neurobiofisica/IntelSBESC2014/README.md

# IntelSBESC2014

Hardware and Software presented at Intel Embedded Systems Competition at SBESC2014

## How to cite

DOI: [10.13140/RG.2.1.4077.7769](http://dx.doi.org/10.13140/RG.2.1.4077.7769) / [arXiv:1504.00932](http://arxiv.org/abs/1504.00932) \[q-bio.QM\]

> LOB de Almeida, P Matias & RT Guariento - An embedded system for real-time feedback neuroscience experiments,
> In: IV Brazilian Symposium on Computing Systems Engineering - SBESC 2014, Intel Embedded Systems Competition
