neurobiofisica/IntelSBESC2014/doc/slides.pdf

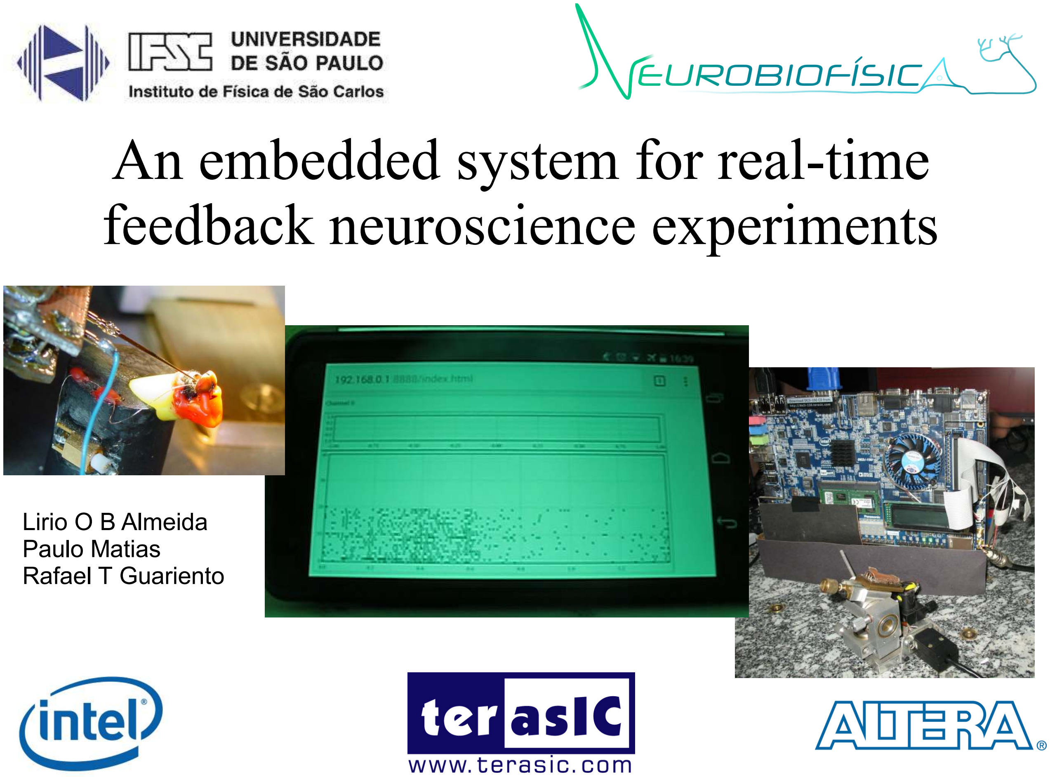
[picture p16: page 1]

An embedded system for real-time feedback neuroscience experiments

Lirio O B Almeida
Paulo Matias
Rafael T Guariento

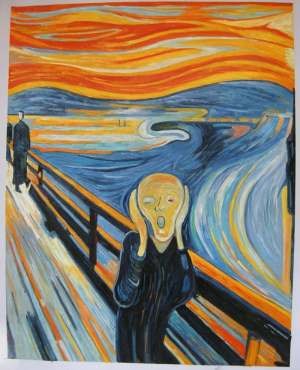
[picture p17: figure]

Why study neuroscience?

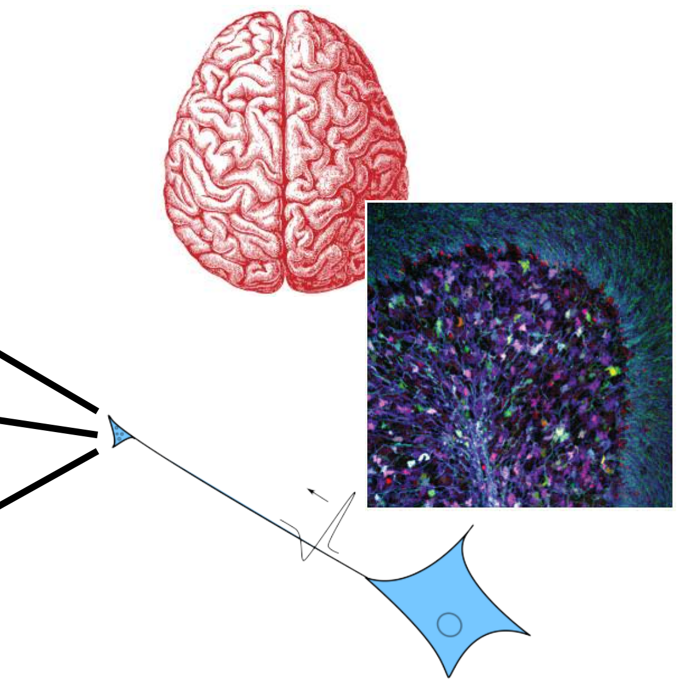
[picture p18: figure]
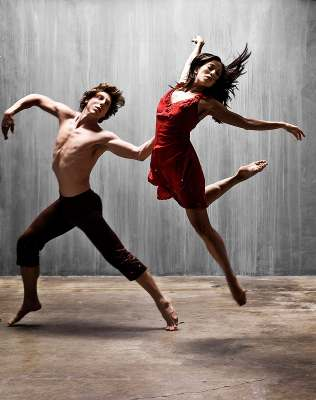
[picture p19: figure]
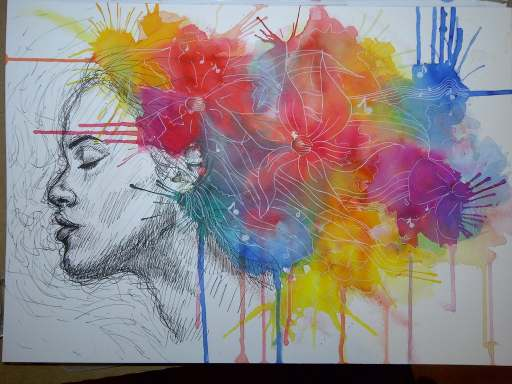
[picture p20: figure]

Neural Code

V

Neural Code

V

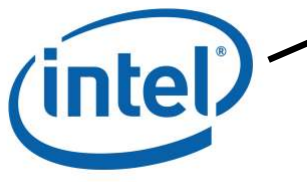
[picture p21: figure]

Encode

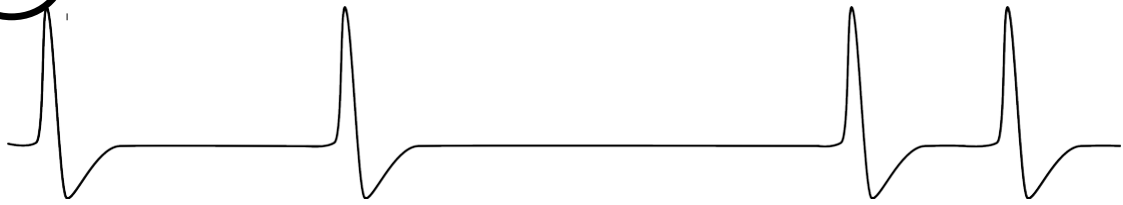
[picture p22: figure]

1 | 0 | 1 | 0 | 0 | 0 | 1 | 1

Neural Code

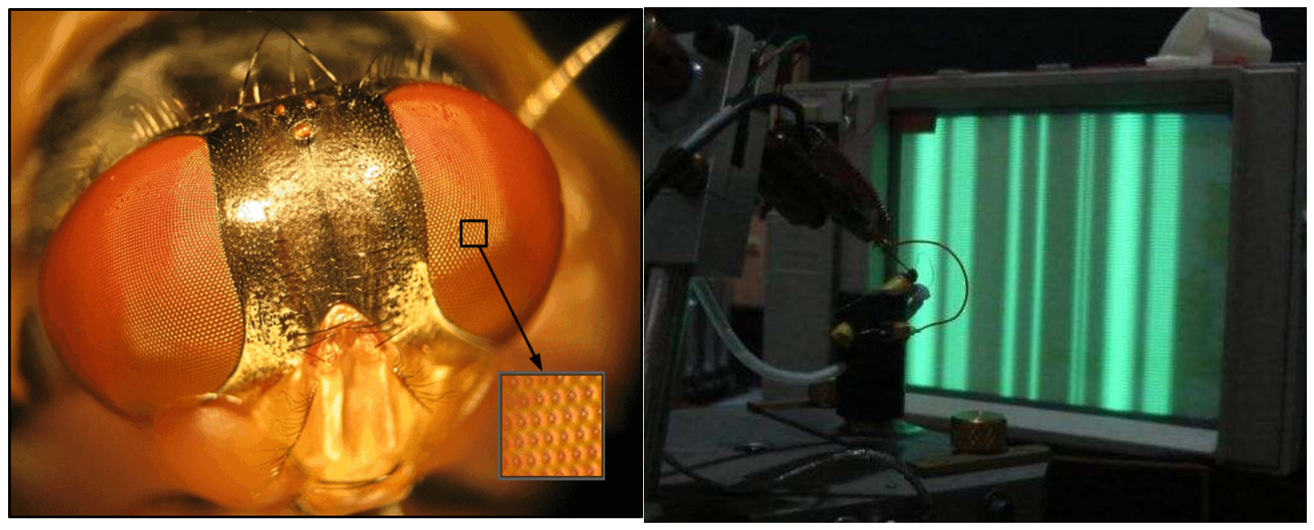
[picture p23: figure]

V

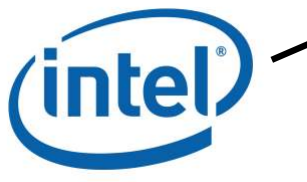
[picture p24: figure]

Encode

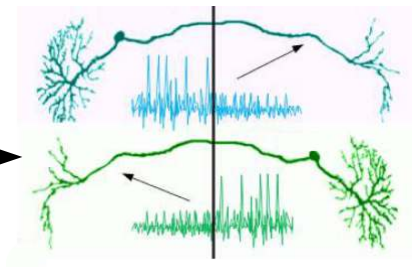
[picture p25: figure]

1 | 0 | 1 | 0 | 0 | 0 | 1 | 1

Neural Code

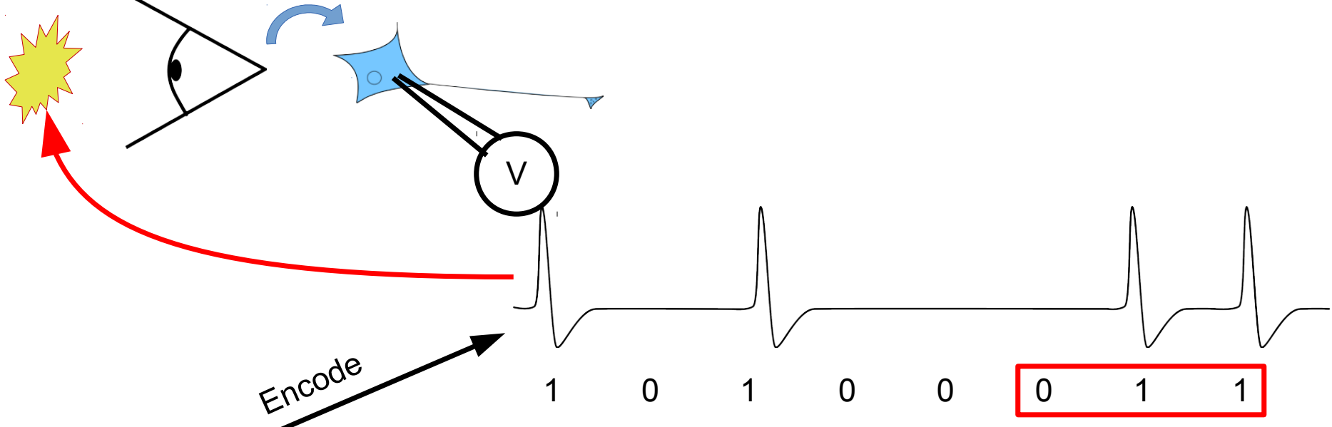
[picture p26: figure]
Encode
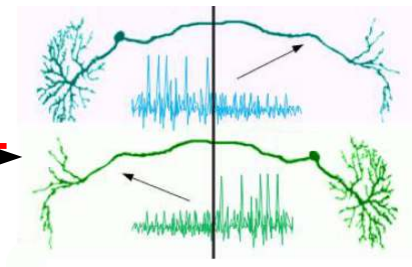
[picture p27: figure]
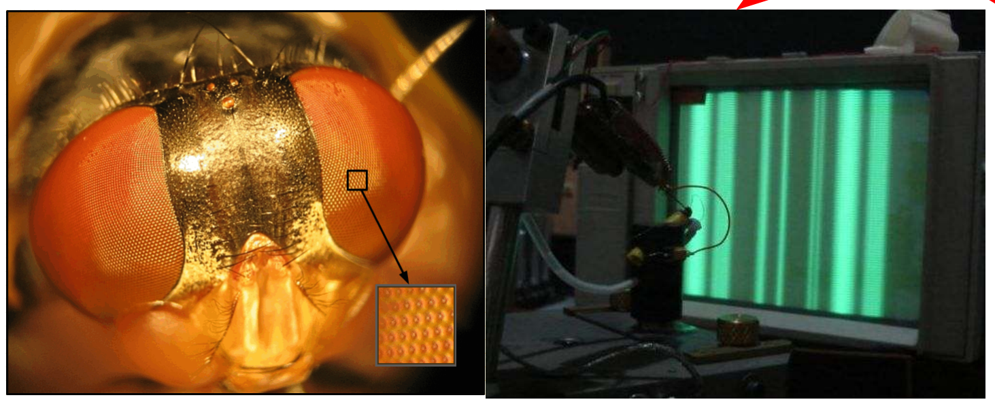
[picture p28: figure]
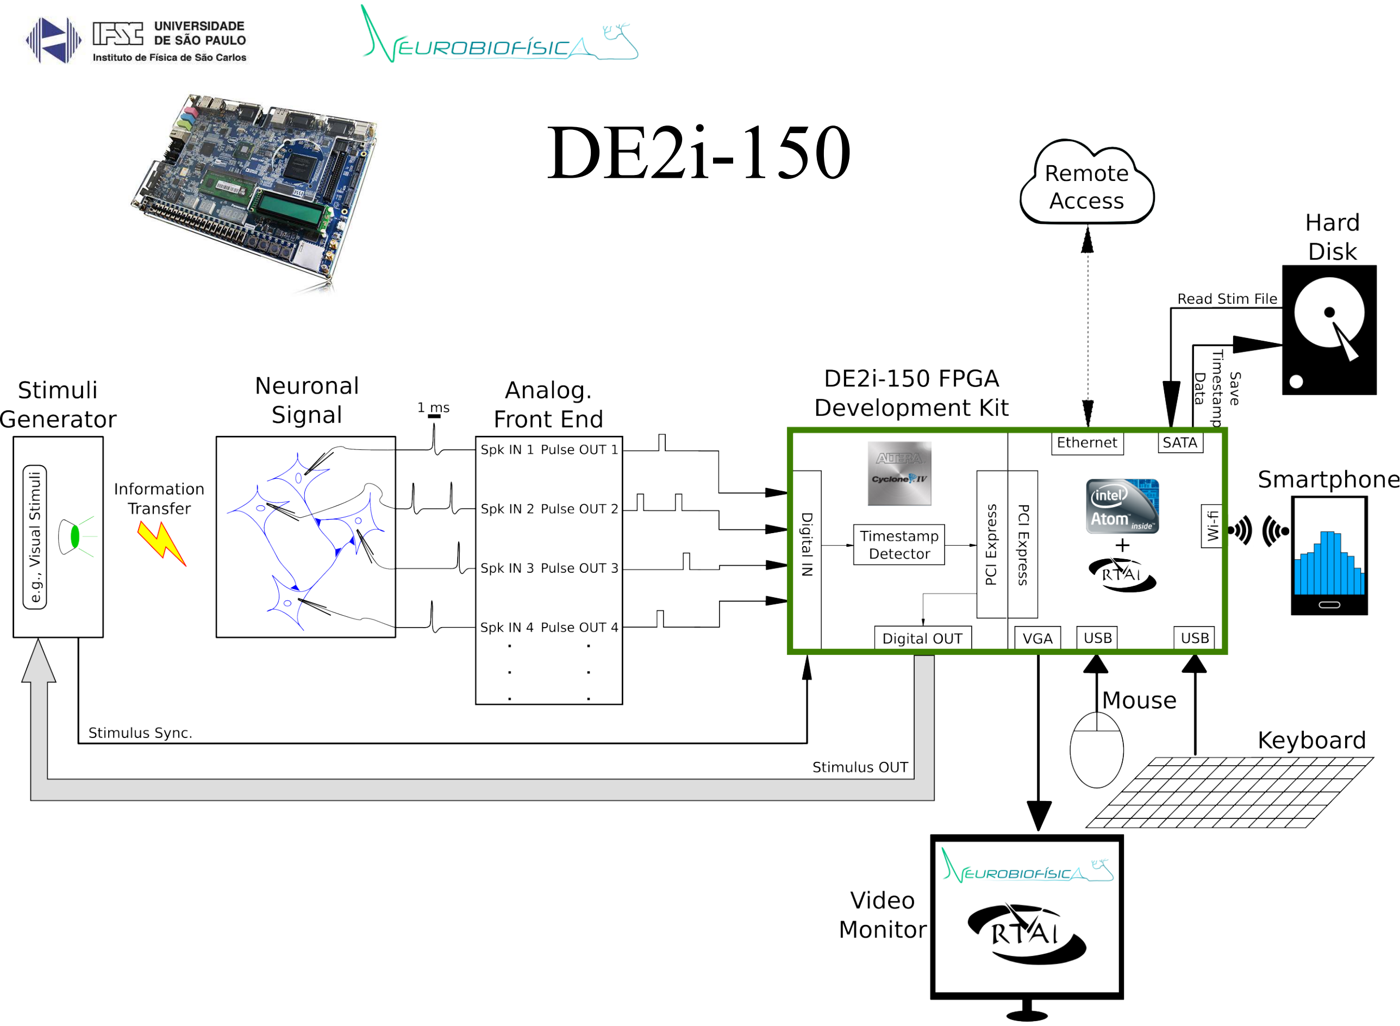
[picture p29: page 7]

DE2i-150

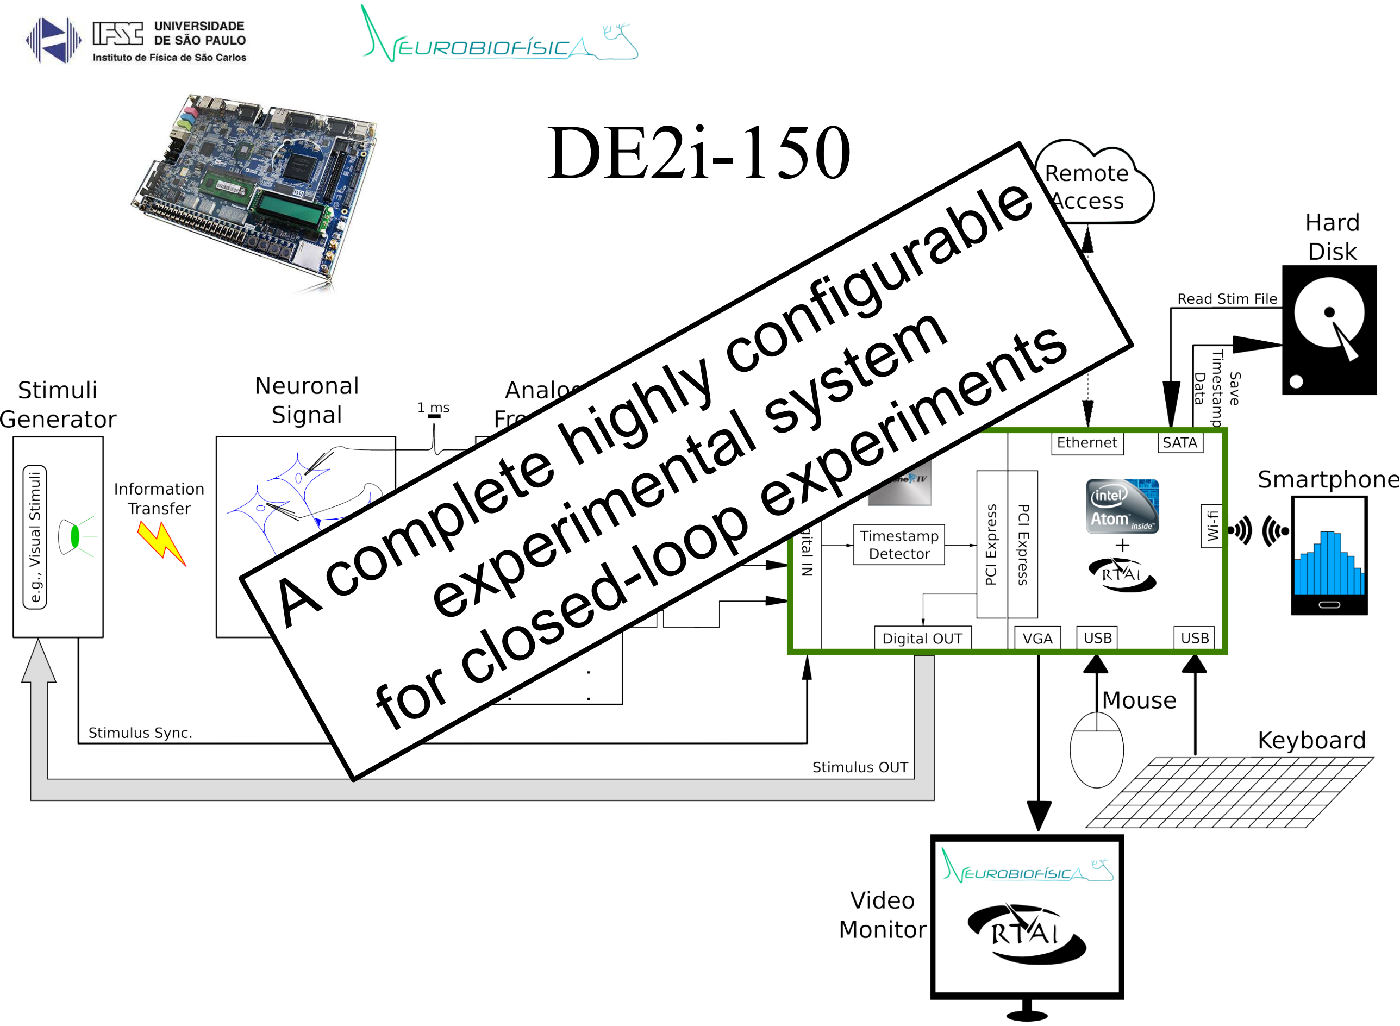
[picture p30: page 8]

DE2i-150
A complete highly configurable

experimental system
for closed-loop experiments

FPGA Altera Cyclone IV

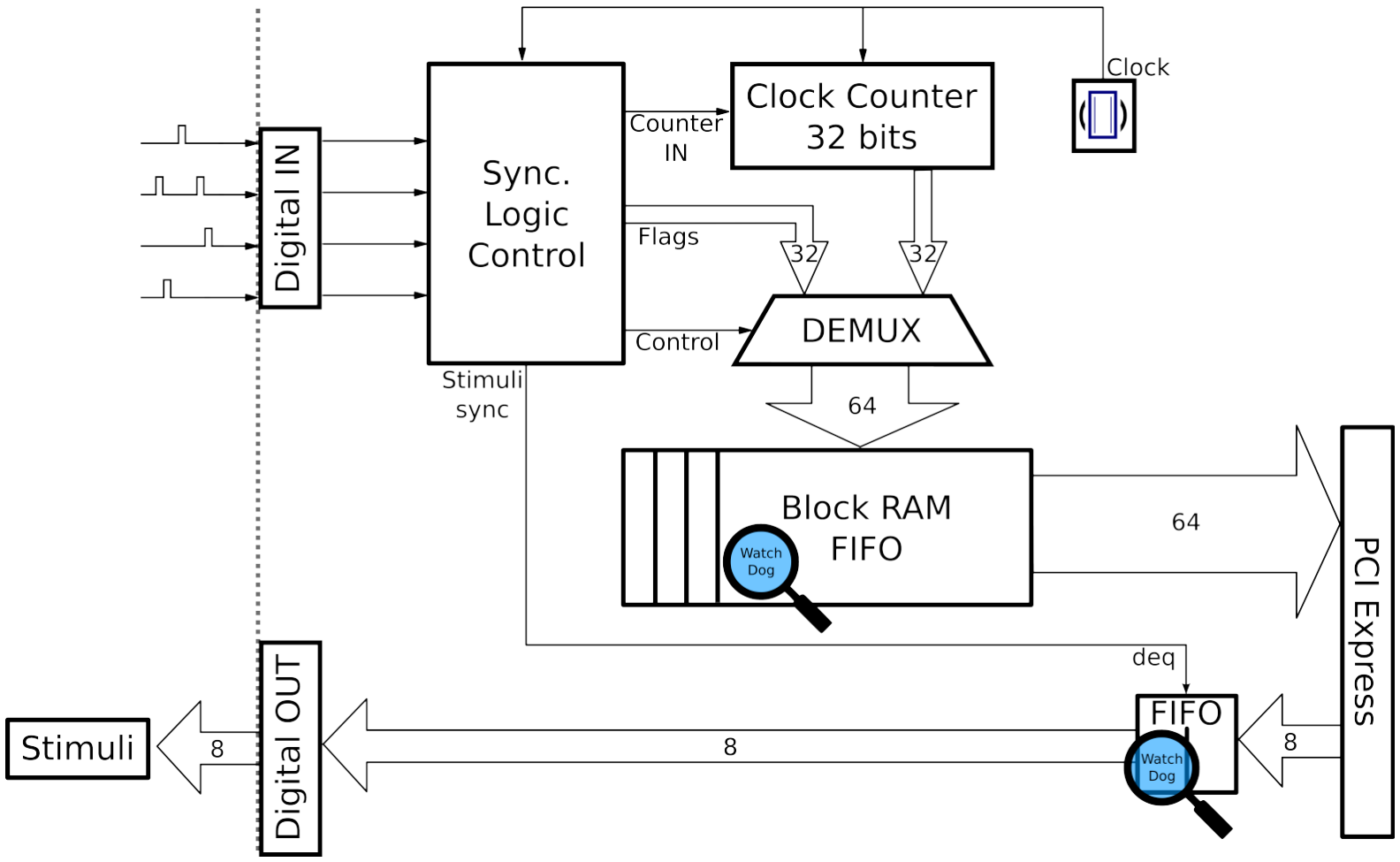
[picture p31: figure]
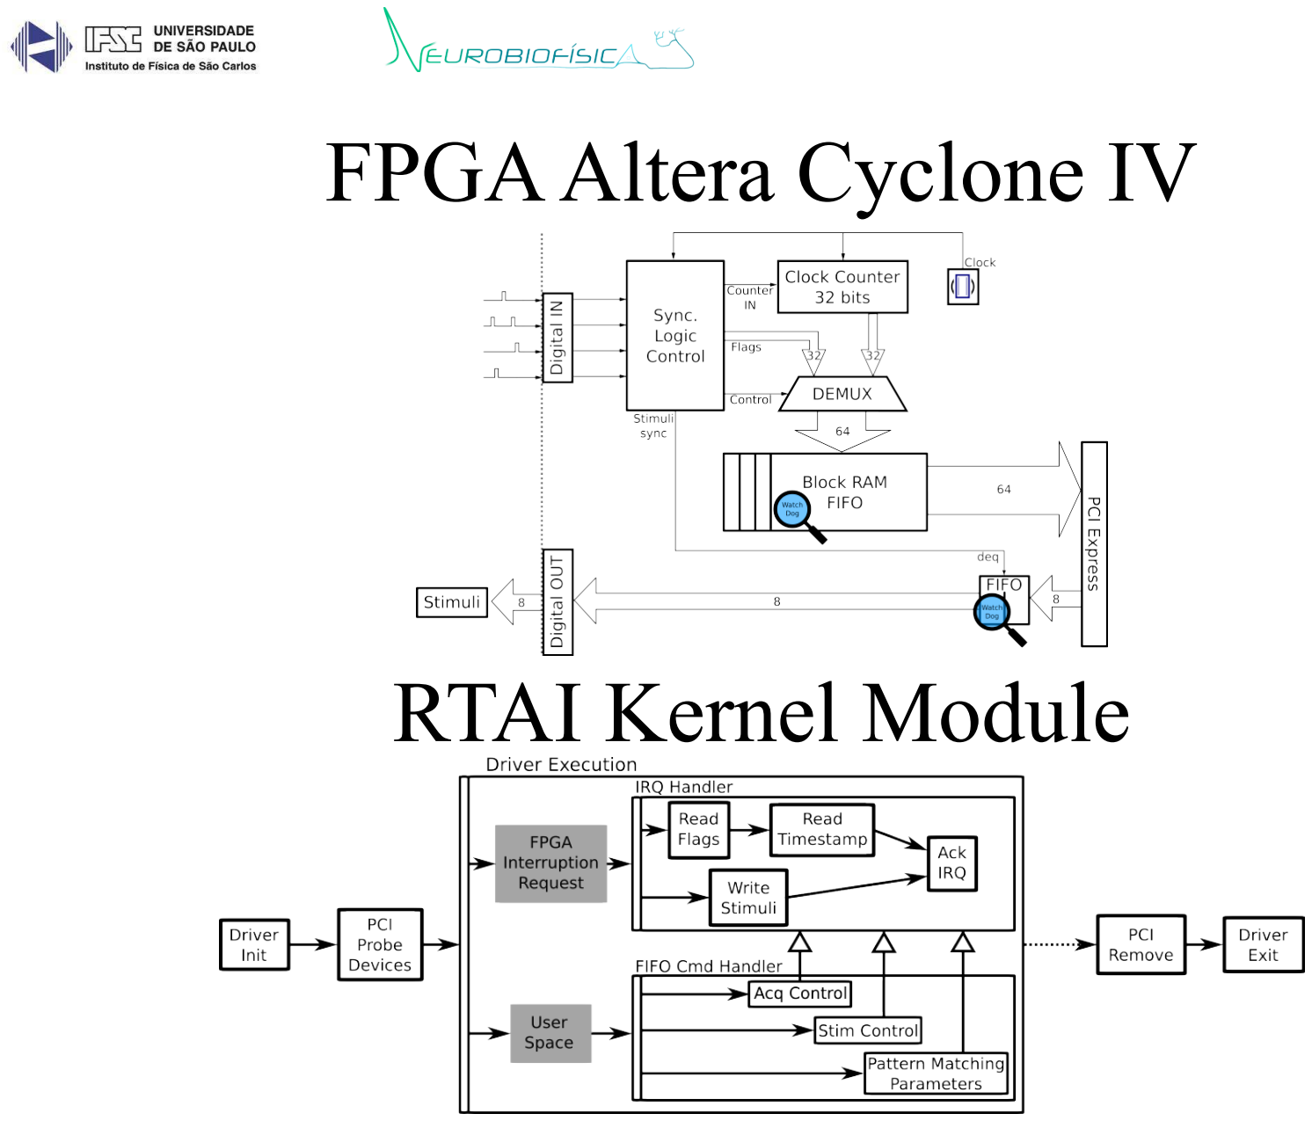
[picture p32: page 10]

FPGA Altera Cyclone IV

RTAI Kernel Module

User Space - Server

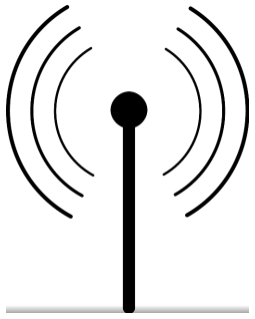
[picture p33: figure]
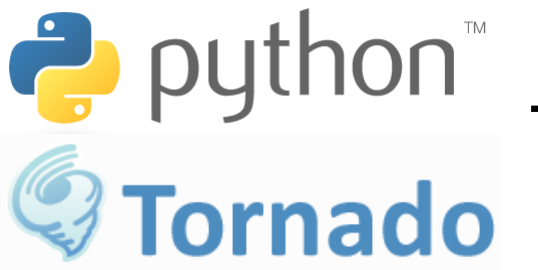
[picture p34: figure]

WebSocket

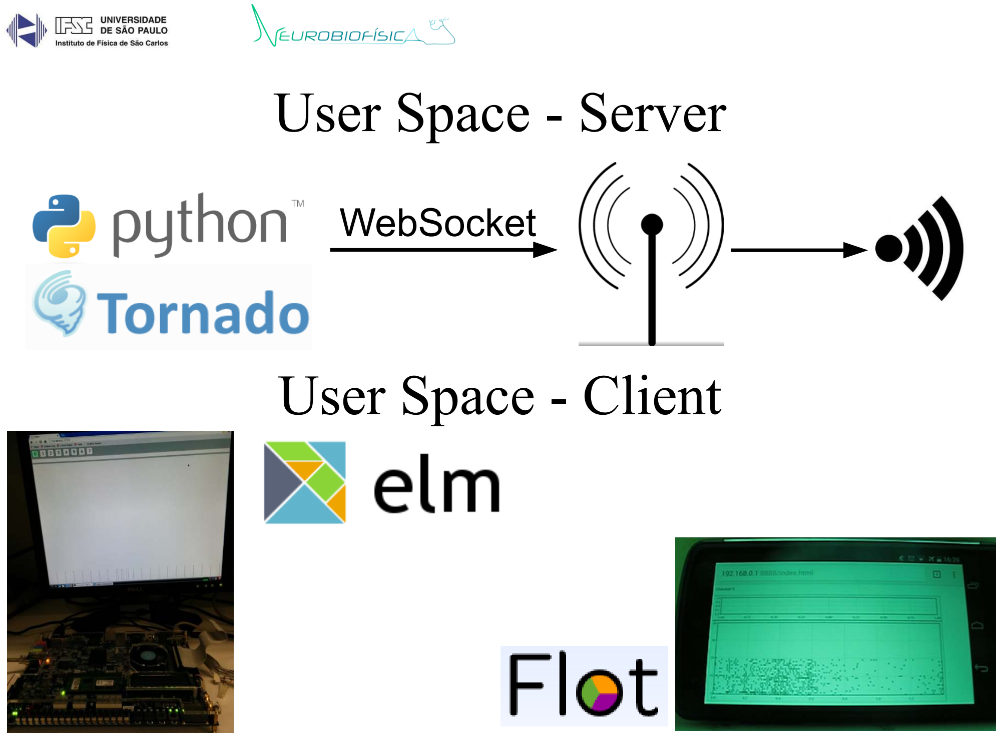
[picture p35: page 12]

User Space - Server

WebSocket

User Space - Client

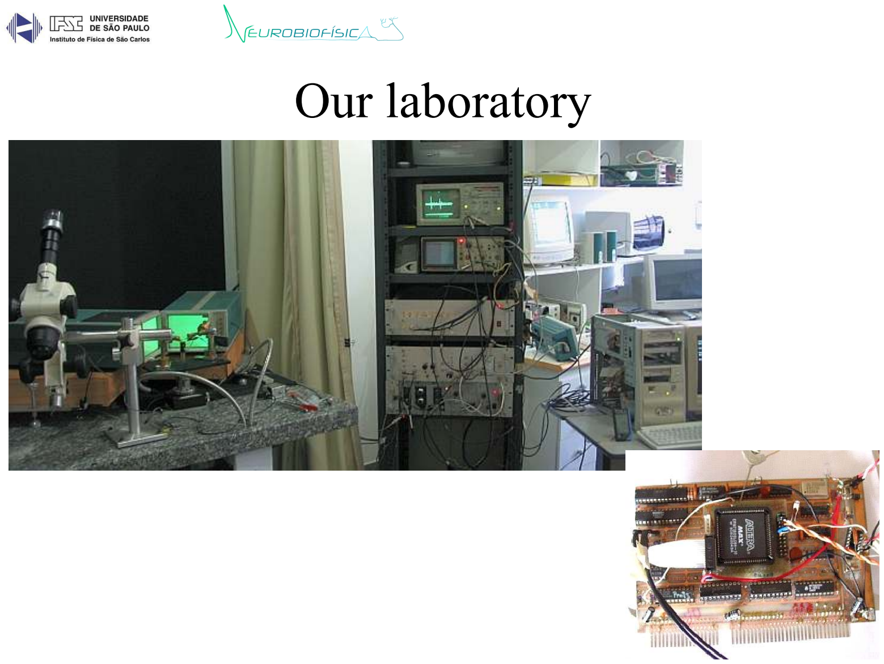
[picture p36: page 13]

Our laboratory

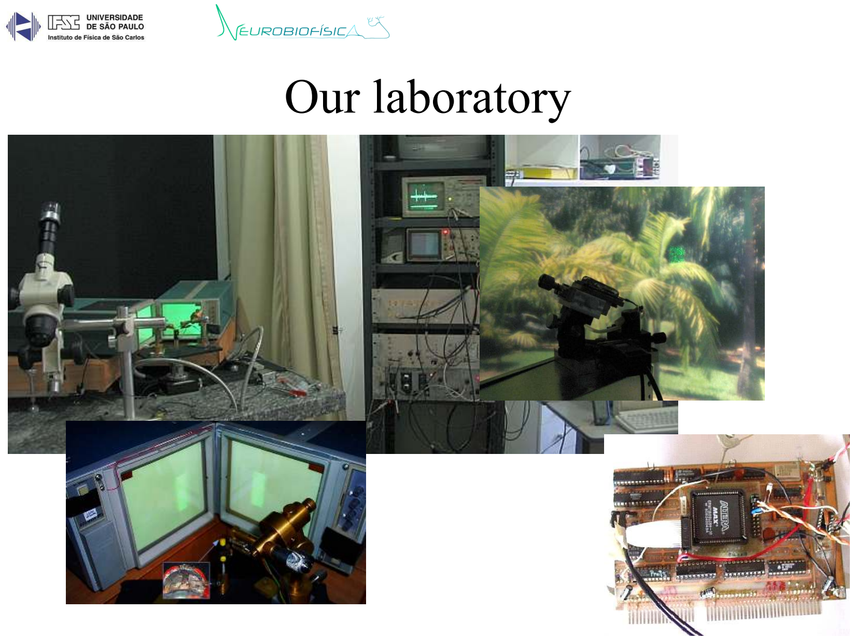
[picture p37: page 14]

Our laboratory

Usual approach | Acquisition System
| ADC

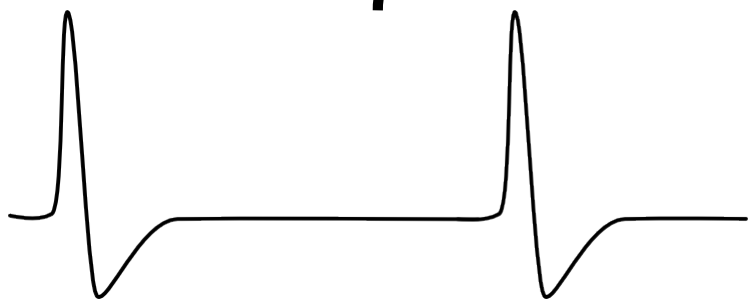
[picture p38: figure]

Real-Time Operating System

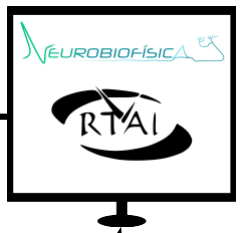
[picture p39: figure]

Our approach

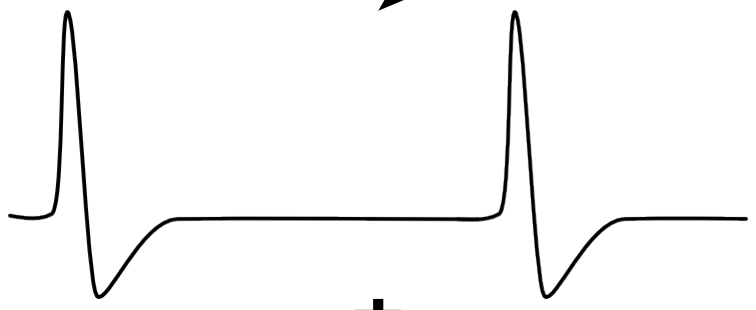
[picture p40: figure]
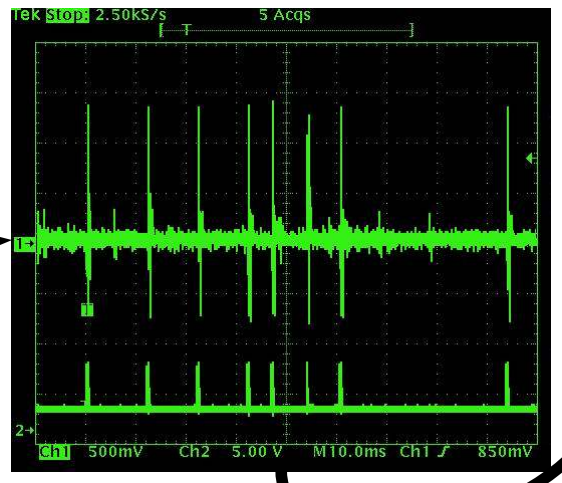
[picture p41: figure]

Analog
Front-End
+
Discriminator

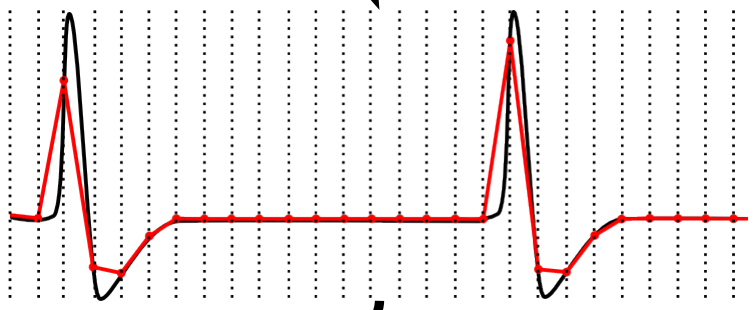
[picture p42: figure]

Timestamp
Event
Detector

Stimuli
Controller

Why RTOS?

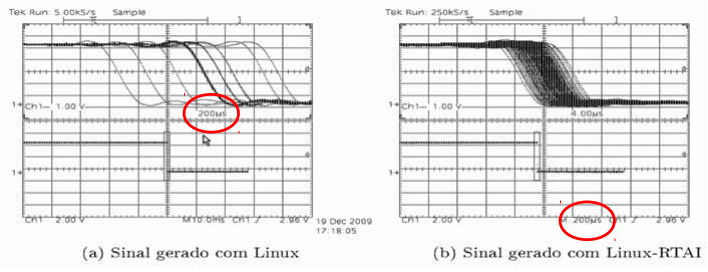
[picture p43: figure]
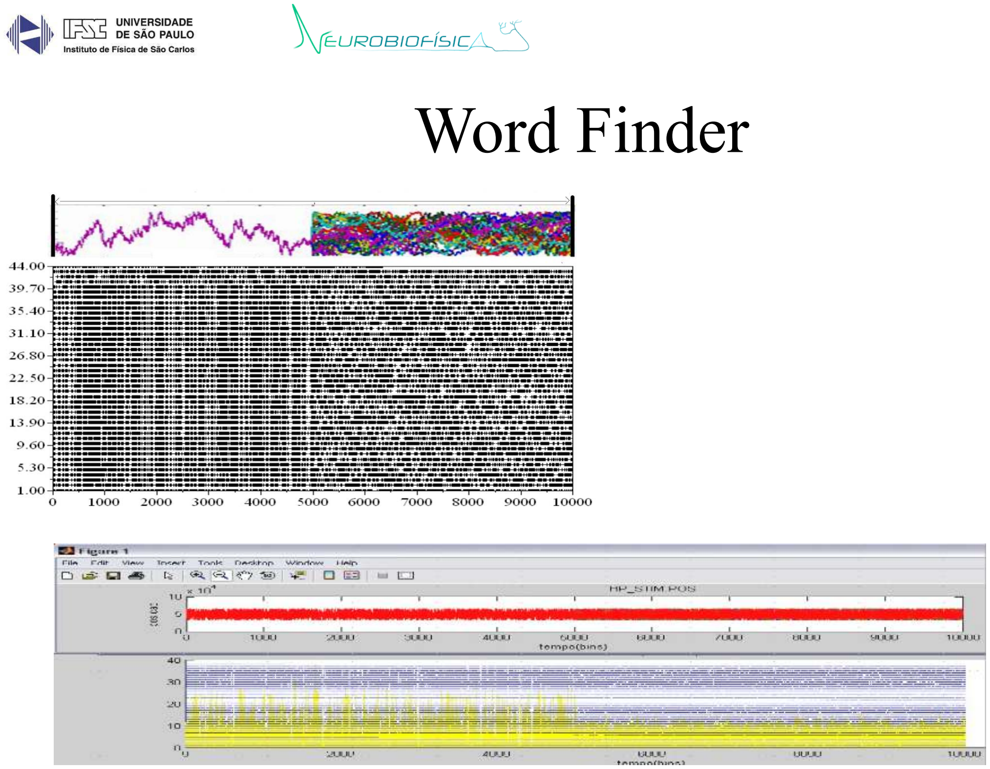
[picture p44: page 18]

Word Finder

Word Finder

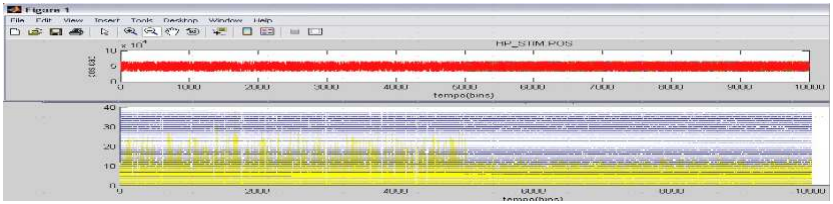
[picture p45: figure]

Periodic Signal of 500ms
Each 10s, a specific word is generated

Video
