neurobiofisica/IntelSBESC2014/(commit log)

2014-11-14 Add Bluespec test project (IRQ dispatched by button)
2014-11-14 Notacao de nomes do QSys
2014-11-14 Forgot irqEnabled in InterruptSender
2014-11-14 Implement button edge detection
2014-11-14 Modificado Makefile para substituir nonsense do QSys
2014-11-14 Invert LEDs and add clear FIFO and error condition on acq stopped
2014-11-14 Increase LED persistence
2014-11-14 Adicionado Arquivos do Driver
2014-11-14 Versao de estimulo funcional
2014-11-14 Adicionado projeto de UserSpace
2014-11-14 Modificado SysConfig na frequencia de estimulo
2014-11-14 colocando FIFOs JTAG para testes
2014-11-14 Driver order change
2014-11-14 Revert original driver
2014-11-14 Zig-zag fixes and documentation changes
    [rtai_pcie_interrupt_driver.c]
